LongDouble/Simple_Embedded_PCB/hardware/Simple_Embedded_PCB/Simple_Embedded_PCB.kicad_pcb

## KiCad design hardware/Simple_Embedded_PCB/Simple_Embedded_PCB.kicad_pcb (2022-12-08)

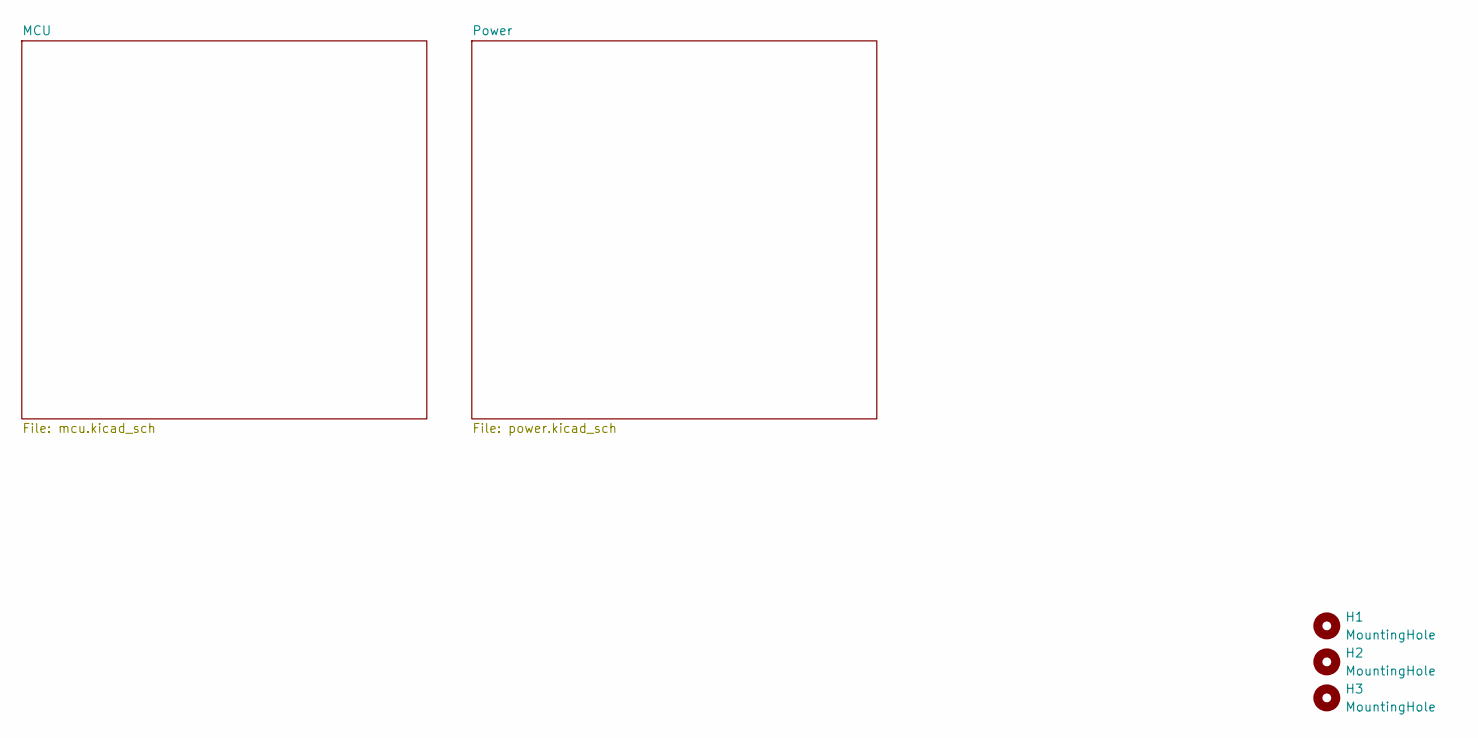
[picture p1: schematic Simple_Embedded_PCB.kicad_sch, STM32F103C8T6 Breakout Board]

Parts:
H1, H2, H3: MountingHole; ToolingHole_JLCPCB

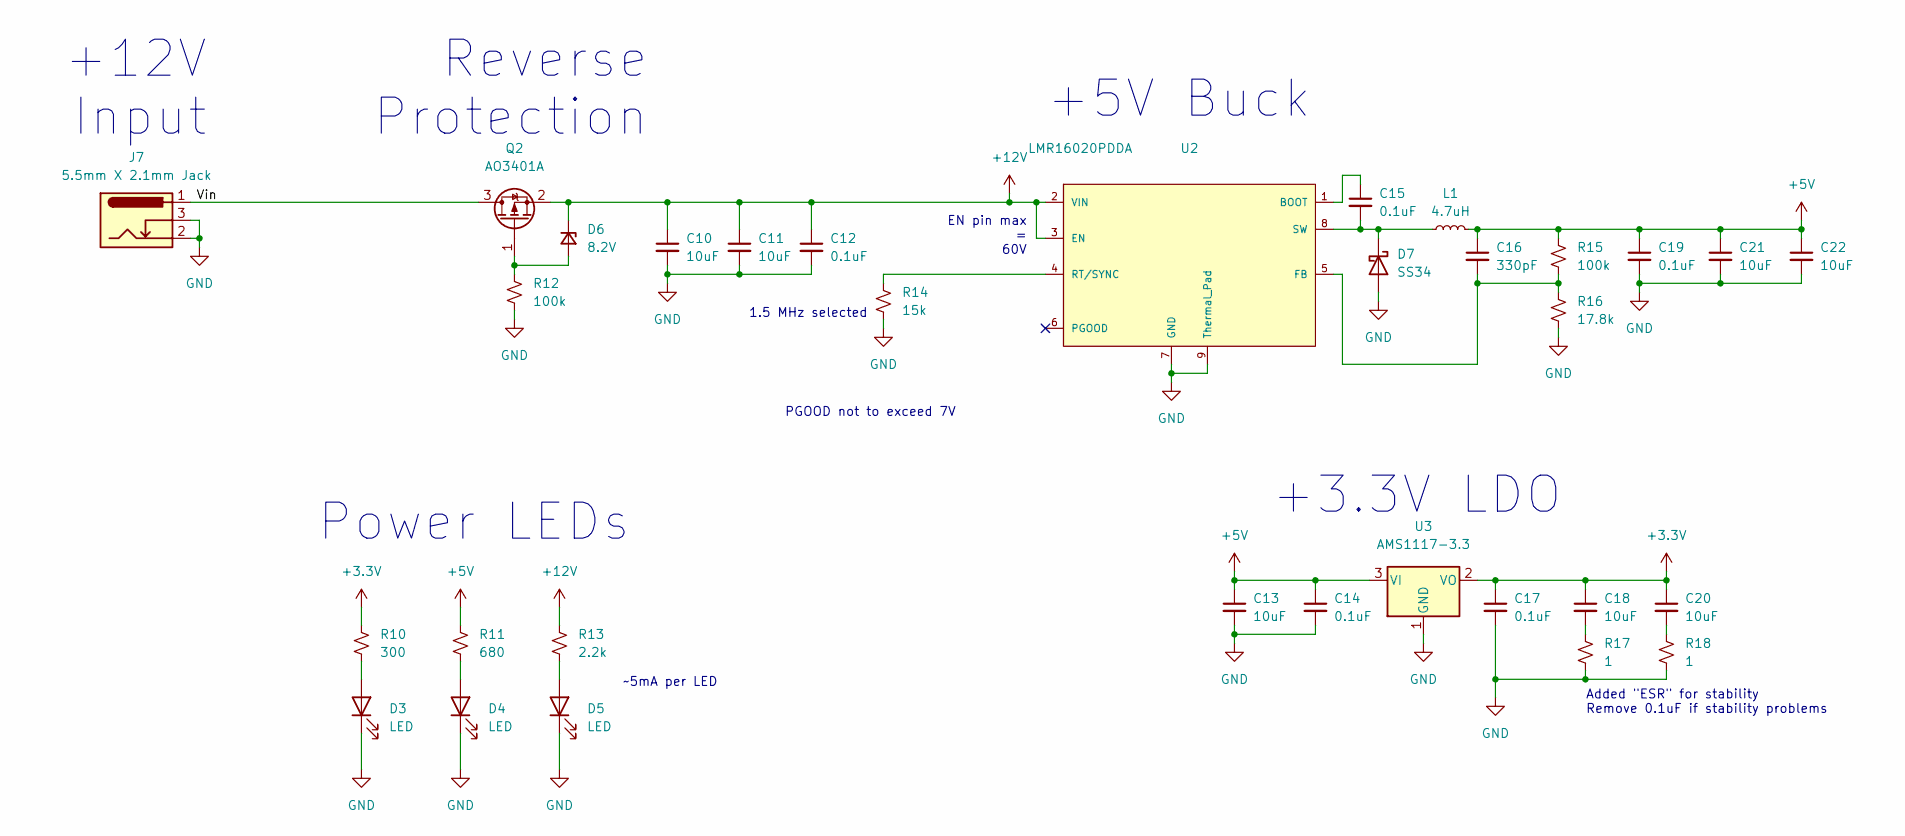
[picture p2: schematic power.kicad_sch]

Parts:
C10, C11, C18, C20, C21, C22: 10uF; C_1206_3216Metric; LCSC Part Number C13585
C12: 0.1uF; C_0603_1608Metric; LCSC Part Number C14663
C13: 10uF; C_0805_2012Metric; LCSC Part Number C440198
C14, C17, C19: 0.1uF; C_0402_1005Metric; LCSC Part Number C307331
C15: 0.1uF; C_0402_1005Metric; Voltage 50V; LCSC Part Number C307331
C16: 330pF; C_0402_1005Metric; LCSC Part Number C13533
D3, D4, D5: LED; LED_0805_2012Metric; LCSC Part Number C2297
D6: 8.2V; D_SOD-123; LCSC Part Number C235988
D7: SS34; D_SMA; LCSC Part Number C8678
J7: 5.5mm X 2.1mm Jack; BarrelJack_Horizontal
L1: 4.7uH; SUNLORD_SWPA6045S4R7MT; LCSC Part Number C78804
Q2: AO3401A; SOT-23; LCSC Part Number C15127
R10: 300; R_0603_1608Metric; LCSC Part Number C23025
R11: 680; R_0603_1608Metric; LCSC Part Number C23228
R12: 100k; R_0603_1608Metric; LCSC Part Number C25803
R13: 2.2k; R_0603_1608Metric; LCSC Part Number C4190
R14: 15k; R_0402_1005Metric; LCSC Part Number C25756
R15: 100k; R_0402_1005Metric; LCSC Part Number C25741
R16: 17.8k; R_0402_1005Metric; LCSC Part Number C226819
R17, R18: 1; R_0603_1608Metric; LCSC Part Number C22936
U2: LMR16020PDDA; 8-PowerSOIC; output voltage 0.8-50V; mouser part number 595-LMR16020PDDA; digikey description IC REG BUCK ADJUSTABLE 2A 8SOPWR
U3: AMS1117-3.3; SOT-223-3_TabPin2; LCSC Part Number C6186

Connections:
+3.3V: C17.1, C18.1, C20.1, R10.2, U3.2 (VO); also elsewhere on the board
+5V: C13.1, C14.1, C16.1, C19.1, C21.1, C22.1, L1.2, R11.2, R15.2, U3.3 (VI); also elsewhere on the board
+12V: C10.1, C11.1, C12.1, D6.1 (K), Q2.2 (S), R13.2, U2.2 (VIN), U2.3 (EN)
/Power/Vin: J7.1, Q2.3 (D)
GND: C10.2, C11.2, C12.2, C13.2, C14.2, C17.2, C19.2, C21.2, C22.2, D3.1 (K), D4.1 (K), D5.1 (K), D7.2 (A), J7.2, J7.3, R12.2, R14.1, R16.1, R17.1, R18.1, U2.7 (GND), U2.9 (Thermal_Pad), U3.1 (GND); also elsewhere on the board
unnamed: C15.1, U2.1 (BOOT)
unnamed: C15.2, D7.1 (K), L1.1, U2.8 (SW)
unnamed: C16.2, R15.1, R16.2, U2.5 (FB)
unnamed: C18.2, R17.2
unnamed: C20.2, R18.2
unnamed: D3.2 (A), R10.1
unnamed: D4.2 (A), R11.1
unnamed: D5.2 (A), R13.1
unnamed: D6.2 (A), Q2.1 (G), R12.1
unnamed: R14.2, U2.4 (RT/SYNC)

Notes on the sheet:
Power LEDs
Reverse Protection
1.5 MHz selected
EN pin max = 60V
Added "ESR" for stability Remove 0.1uF if stability problems
~5mA per LED
PGOOD not to exceed 7V
+5V Buck
+12V Input
+3.3V LDO

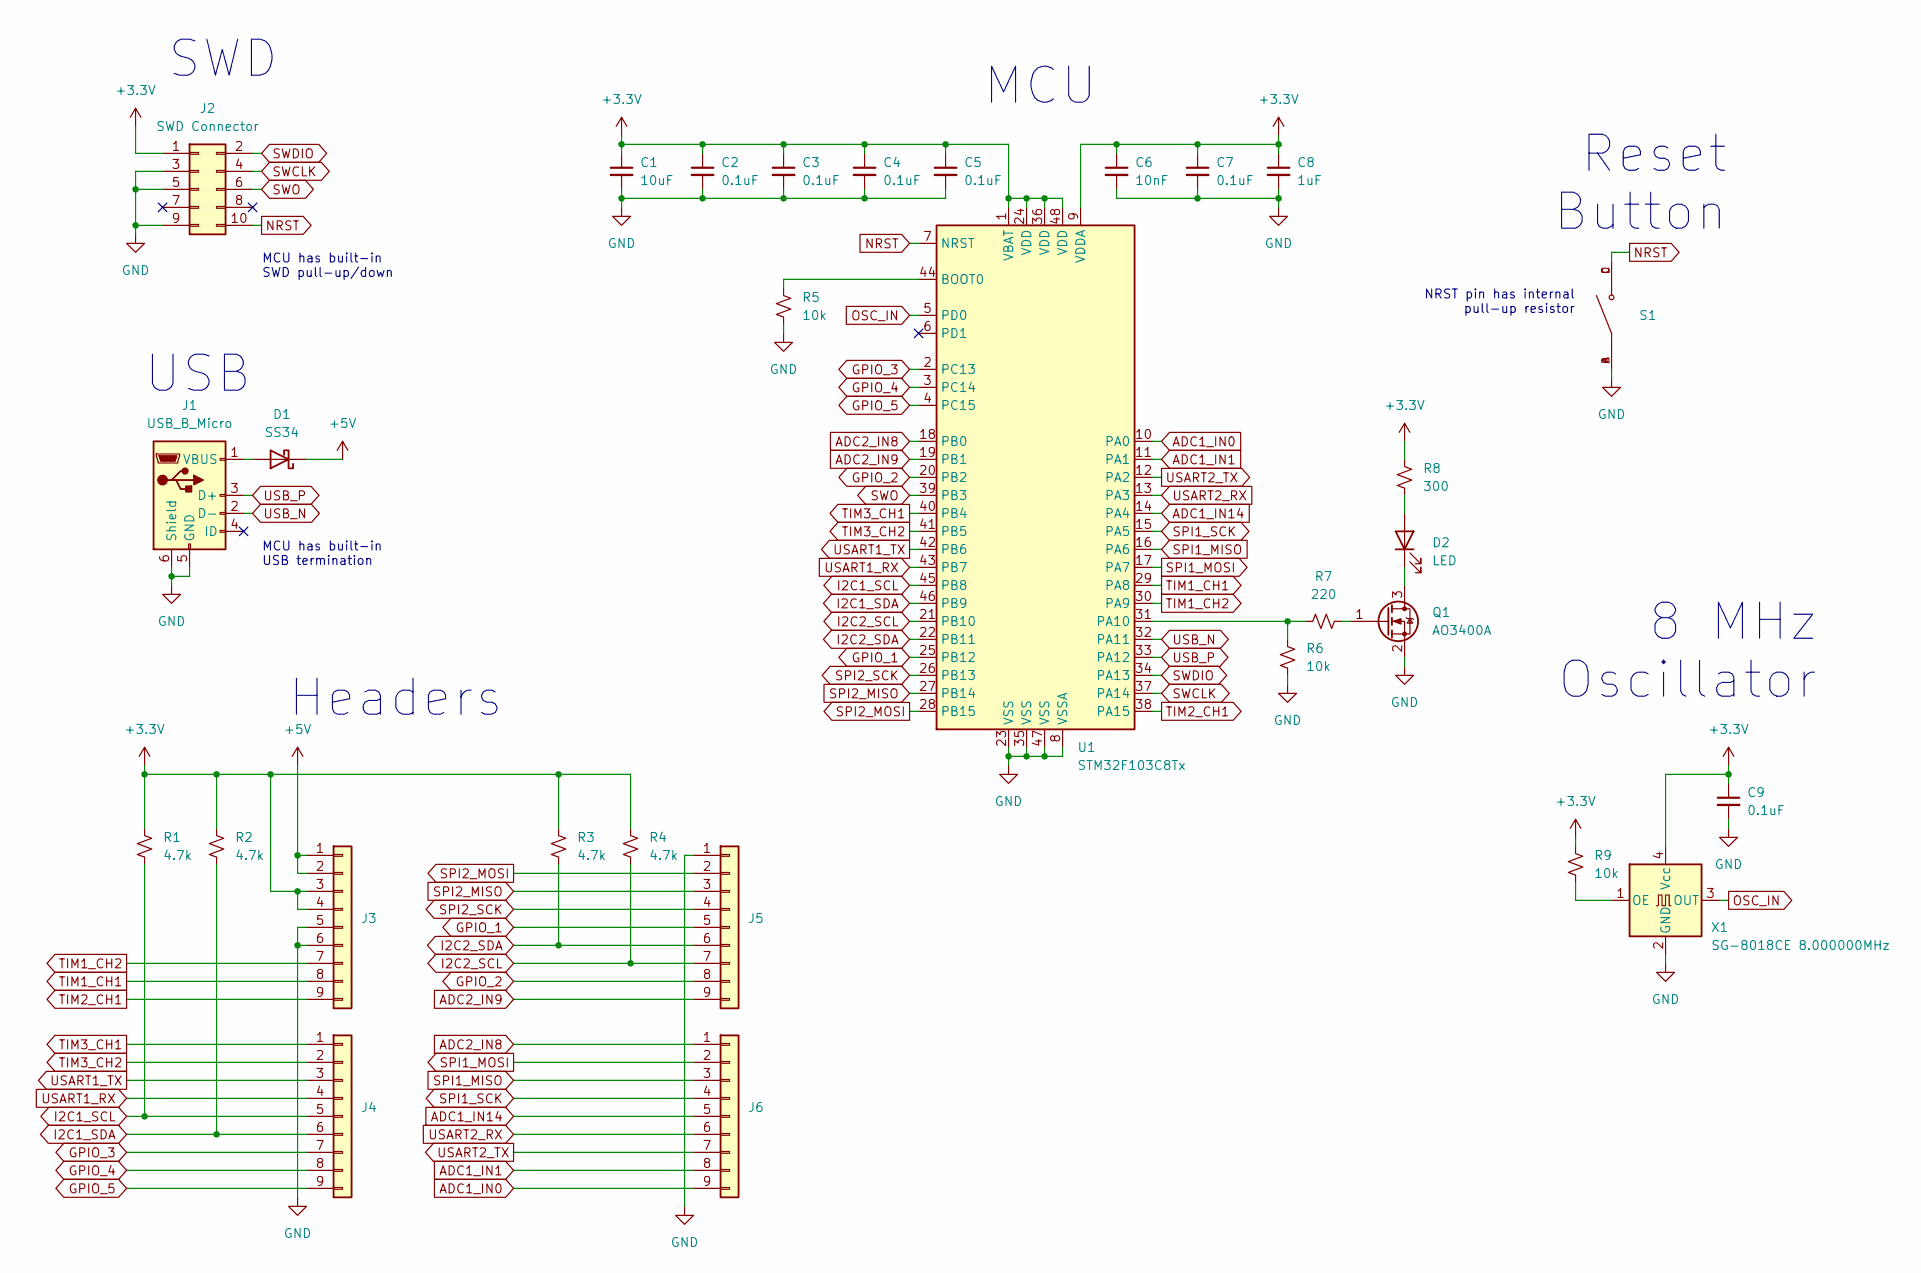
[picture p3: schematic mcu.kicad_sch]

Parts:
C1: 10uF; C_0805_2012Metric; LCSC Part Number C440198
C2, C3, C4, C5, C7, C9: 0.1uF; C_0402_1005Metric; LCSC Part Number C307331
C6: 10nF; C_0402_1005Metric; LCSC Part Number C15195
C8: 1uF; C_0603_1608Metric; LCSC Part Number C15849
D1: SS34; D_SMA; LCSC Part Number C8678
D2: LED; LED_0805_2012Metric; LCSC Part Number C2297
J1: USB_B_Micro; USB_Micro-B_Amphenol_10118194_Horizontal; LCSC Part Number C132563
J2: SWD Connector; Amphenol-20021121-0-0-0; LCSC Part Number C598540
J3, J4, J5, J6: Conn_01x09; PinHeader_1x09_P2.54mm_Vertical
Q1: AO3400A; SOT-23; LCSC Part Number C20917
R1, R2, R3, R4: 4.7k; R_0402_1005Metric; LCSC Part Number C25900
R5, R6, R9: 10k; R_0402_1005Metric; LCSC Part Number C25744
R7: 220; R_0402_1005Metric; LCSC Part Number C25091
R8: 300; R_0603_1608Metric; LCSC Part Number C23025
S1: TS-1187A-B-A-B; SW_TS-1187A-B-A-B
U1: STM32F103C8Tx; LQFP-48_7x7mm_P0.5mm; LCSC Part Number C8734
X1: SG-8018CE 8.000000MHz; Oscillator_SMD_SeikoEpson_SG8002CE-4Pin_3.2x2.5mm; LCSC Part Number C390495

Connections:
+3.3V: C1.1, C2.1, C3.1, C4.1, C5.1, C6.1, C7.1, C8.1, C9.1, J2.1, J3.3, J3.4, R1.1, R2.1, R3.1, R4.1, R8.2, R9.1, U1.1 (VBAT), U1.9 (VDDA), U1.24 (VDD), U1.36 (VDD), U1.48 (VDD), X1.4 (Vcc); also elsewhere on the board
+5V: D1.1 (K), J3.1, J3.2; also elsewhere on the board
ADC1_IN0: J6.9, U1.10 (PA0)
ADC1_IN1: J6.8, U1.11 (PA1)
ADC1_IN14: J6.5, U1.14 (PA4)
ADC2_IN8: J6.1, U1.18 (PB0)
ADC2_IN9: J5.9, U1.19 (PB1)
GND: C1.2, C2.2, C3.2, C4.2, C5.2, C6.2, C7.2, C8.2, C9.2, J1.5 (GND), J1.6 (Shield), J2.3, J2.5, J2.9, J3.5, J3.6, J5.1, Q1.2 (S), R5.2, R6.2, S1.A, S1.B, U1.8 (VSSA), U1.23 (VSS), U1.35 (VSS), U1.47 (VSS), X1.2 (GND); also elsewhere on the board
GPIO_1: J5.5, U1.25 (PB12)
GPIO_2: J5.8, U1.20 (PB2)
GPIO_3: J4.7, U1.2 (PC13)
GPIO_4: J4.8, U1.3 (PC14)
GPIO_5: J4.9, U1.4 (PC15)
I2C1_SCL: J4.5, R1.2, U1.45 (PB8)
I2C1_SDA: J4.6, R2.2, U1.46 (PB9)
I2C2_SCL: J5.7, R4.2, U1.21 (PB10)
I2C2_SDA: J5.6, R3.2, U1.22 (PB11)
NRST: J2.10, S1.C, S1.D, U1.7 (NRST)
unnamed: D1.2 (A), J1.1 (VBUS)
unnamed: D2.1 (K), Q1.3 (D)
unnamed: D2.2 (A), R8.1
unnamed: Q1.1 (G), R7.2
unnamed: R5.1, U1.44 (BOOT0)
unnamed: R6.1, R7.1, U1.31 (PA10)
unnamed: R9.2, X1.1 (OE)
OSC_IN: U1.5 (PD0), X1.3 (OUT)
SPI1_MISO: J6.3, U1.16 (PA6)
SPI1_MOSI: J6.2, U1.17 (PA7)
SPI1_SCK: J6.4, U1.15 (PA5)
SPI2_MISO: J5.3, U1.27 (PB14)
SPI2_MOSI: J5.2, U1.28 (PB15)
SPI2_SCK: J5.4, U1.26 (PB13)
SWCLK: J2.4, U1.37 (PA14)
SWDIO: J2.2, U1.34 (PA13)
SWO: J2.6, U1.39 (PB3)
TIM1_CH1: J3.8, U1.29 (PA8)
TIM1_CH2: J3.7, U1.30 (PA9)
TIM2_CH1: J3.9, U1.38 (PA15)
TIM3_CH1: J4.1, U1.40 (PB4)
TIM3_CH2: J4.2, U1.41 (PB5)
USART1_RX: J4.4, U1.43 (PB7)
USART1_TX: J4.3, U1.42 (PB6)
USART2_RX: J6.6, U1.13 (PA3)
USART2_TX: J6.7, U1.12 (PA2)
USB_N: J1.2 (D-), U1.32 (PA11)
USB_P: J1.3 (D+), U1.33 (PA12)

Notes on the sheet:
USB
MCU
Headers
8 MHz Oscillator
MCU has built-in USB termination
SWD
MCU has built-in SWD pull-up/down
Reset Button
NRST pin has internal pull-up resistor

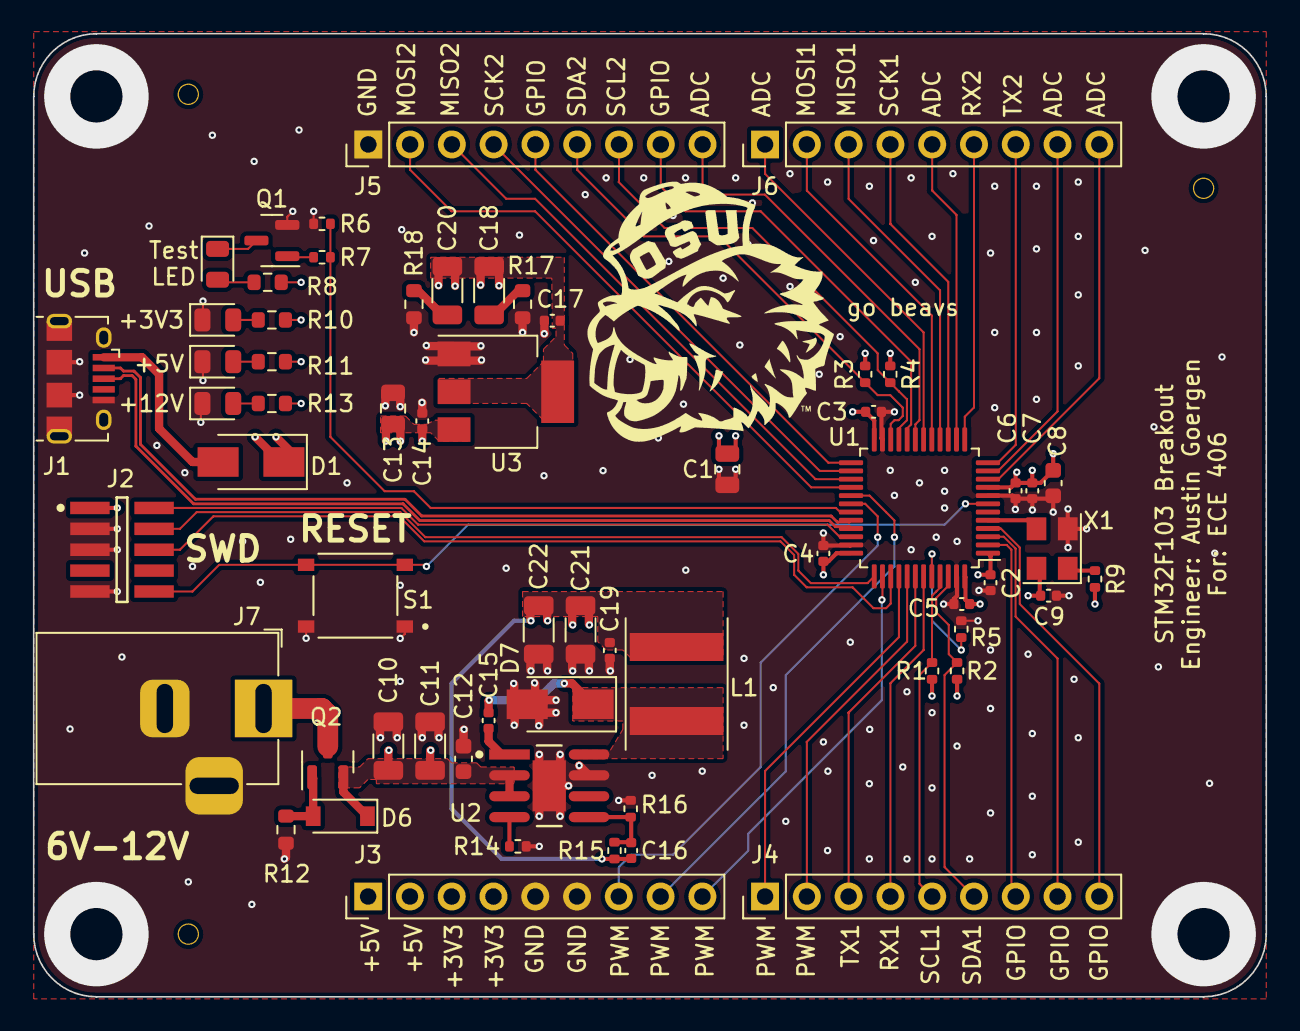
[picture p4: board Simple_Embedded_PCB.kicad_pcb from above]

Board: 4 copper layers, 74.9 x 58.5 mm, 65 parts (0 on the bottom side), 58 nets.
