LongDouble/Simple_Embedded_PCB/(commit log)

2022-10-09 Created firmware with pin configurations
2022-10-17 Started schematic. Added MCU, decoupling caps, reset switch, oscillator, USB connector, SWD connector, 3.3 volt and 5 volt power leds, PWM led, input power and reset protection
    [Simple_Embedded_PCB.kicad_pcb, Simple_Embedded_PCB.kicad_sch]
2022-10-18 Update Simple_Embedded_PCB.kicad_sch
    Added 5V and 3.3V regulators, add unpopulated header pins
    [Simple_Embedded_PCB.kicad_sch]
2022-10-20 Split MCU and Power into different sheets, created header pinouts, finished schematic and annotation
    [Simple_Embedded_PCB.kicad_sch, mcu.kicad_sch, power.kicad_sch]
2022-10-21 Added 4.7k pullups to I2C and reannotated
    [Simple_Embedded_PCB.kicad_sch, mcu.kicad_sch, power.kicad_sch]
2022-10-21 Removed comment regarding PGOOD floating, changed PGOOD PU resistor
    [Simple_Embedded_PCB.kicad_sch, mcu.kicad_sch, power.kicad_sch]
2022-10-22 Preliminary layout done, removed resistors from PGOOD to just leave it floating
    [Simple_Embedded_PCB.kicad_pcb, Simple_Embedded_PCB.kicad_sch, mcu.kicad_sch, power.kicad_sch]
2022-10-22 Setup design rules and created proper board outline with mounting holes
    [Simple_Embedded_PCB.kicad_pcb, mcu.kicad_sch]
2022-10-22 Routed all PCB traces, began routing power
    [Simple_Embedded_PCB.kicad_pcb, mcu.kicad_sch]
2022-10-23 Finished layout, added step models and silkscreen
    [Simple_Embedded_PCB.kicad_pcb]
2022-10-23 Added tooling holes and put JLCPCB order number on back of board, added kicad_prl file to git ignore
    [Simple_Embedded_PCB.kicad_pcb, Simple_Embedded_PCB.kicad_sch]
2022-10-23 Removed kicad_prl file
2022-10-23 Added JLCPCB part numbers
    [Simple_Embedded_PCB.kicad_pcb, Simple_Embedded_PCB.kicad_sch, mcu.kicad_sch, power.kicad_sch]
2022-10-23 Board ordered! Created Gerber files, drill files, BOM, and parts placement file.
    [Simple_Embedded_PCB.csv, power.kicad_sch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]
2022-10-23 Removing extra copy of BOM
    [Simple_Embedded_PCB.csv]
2022-11-20 Changed KiCad project to use symbols, footprints, and 3D models from project itself.
    [Simple_Embedded_PCB.kicad_pcb, Simple_Embedded_PCB.kicad_sch, mcu.kicad_sch, power.kicad_sch]
2022-12-08 Changed size of oscillator 3D model to a realistic size
    [Simple_Embedded_PCB.kicad_pcb]
